HBoyd255/norm-motor-control-board/README.md

# N.O.R.M. Motor Control Board <br> (Neat Omnidirectional Robotic Module)

<!-- Harry Boyd - 30/10/2024 - github.com/hboyd255 -->

This is a board that controls the motors on Project N.O.R.M. It uses an arduino
nano 33 BLE as the controller.
