HBoyd255/norm-motor-control-board/hardware/NORMMotorControlBoard.kicad_pcb

## KiCad design hardware/NORMMotorControlBoard.kicad_pcb (2025-02-17)

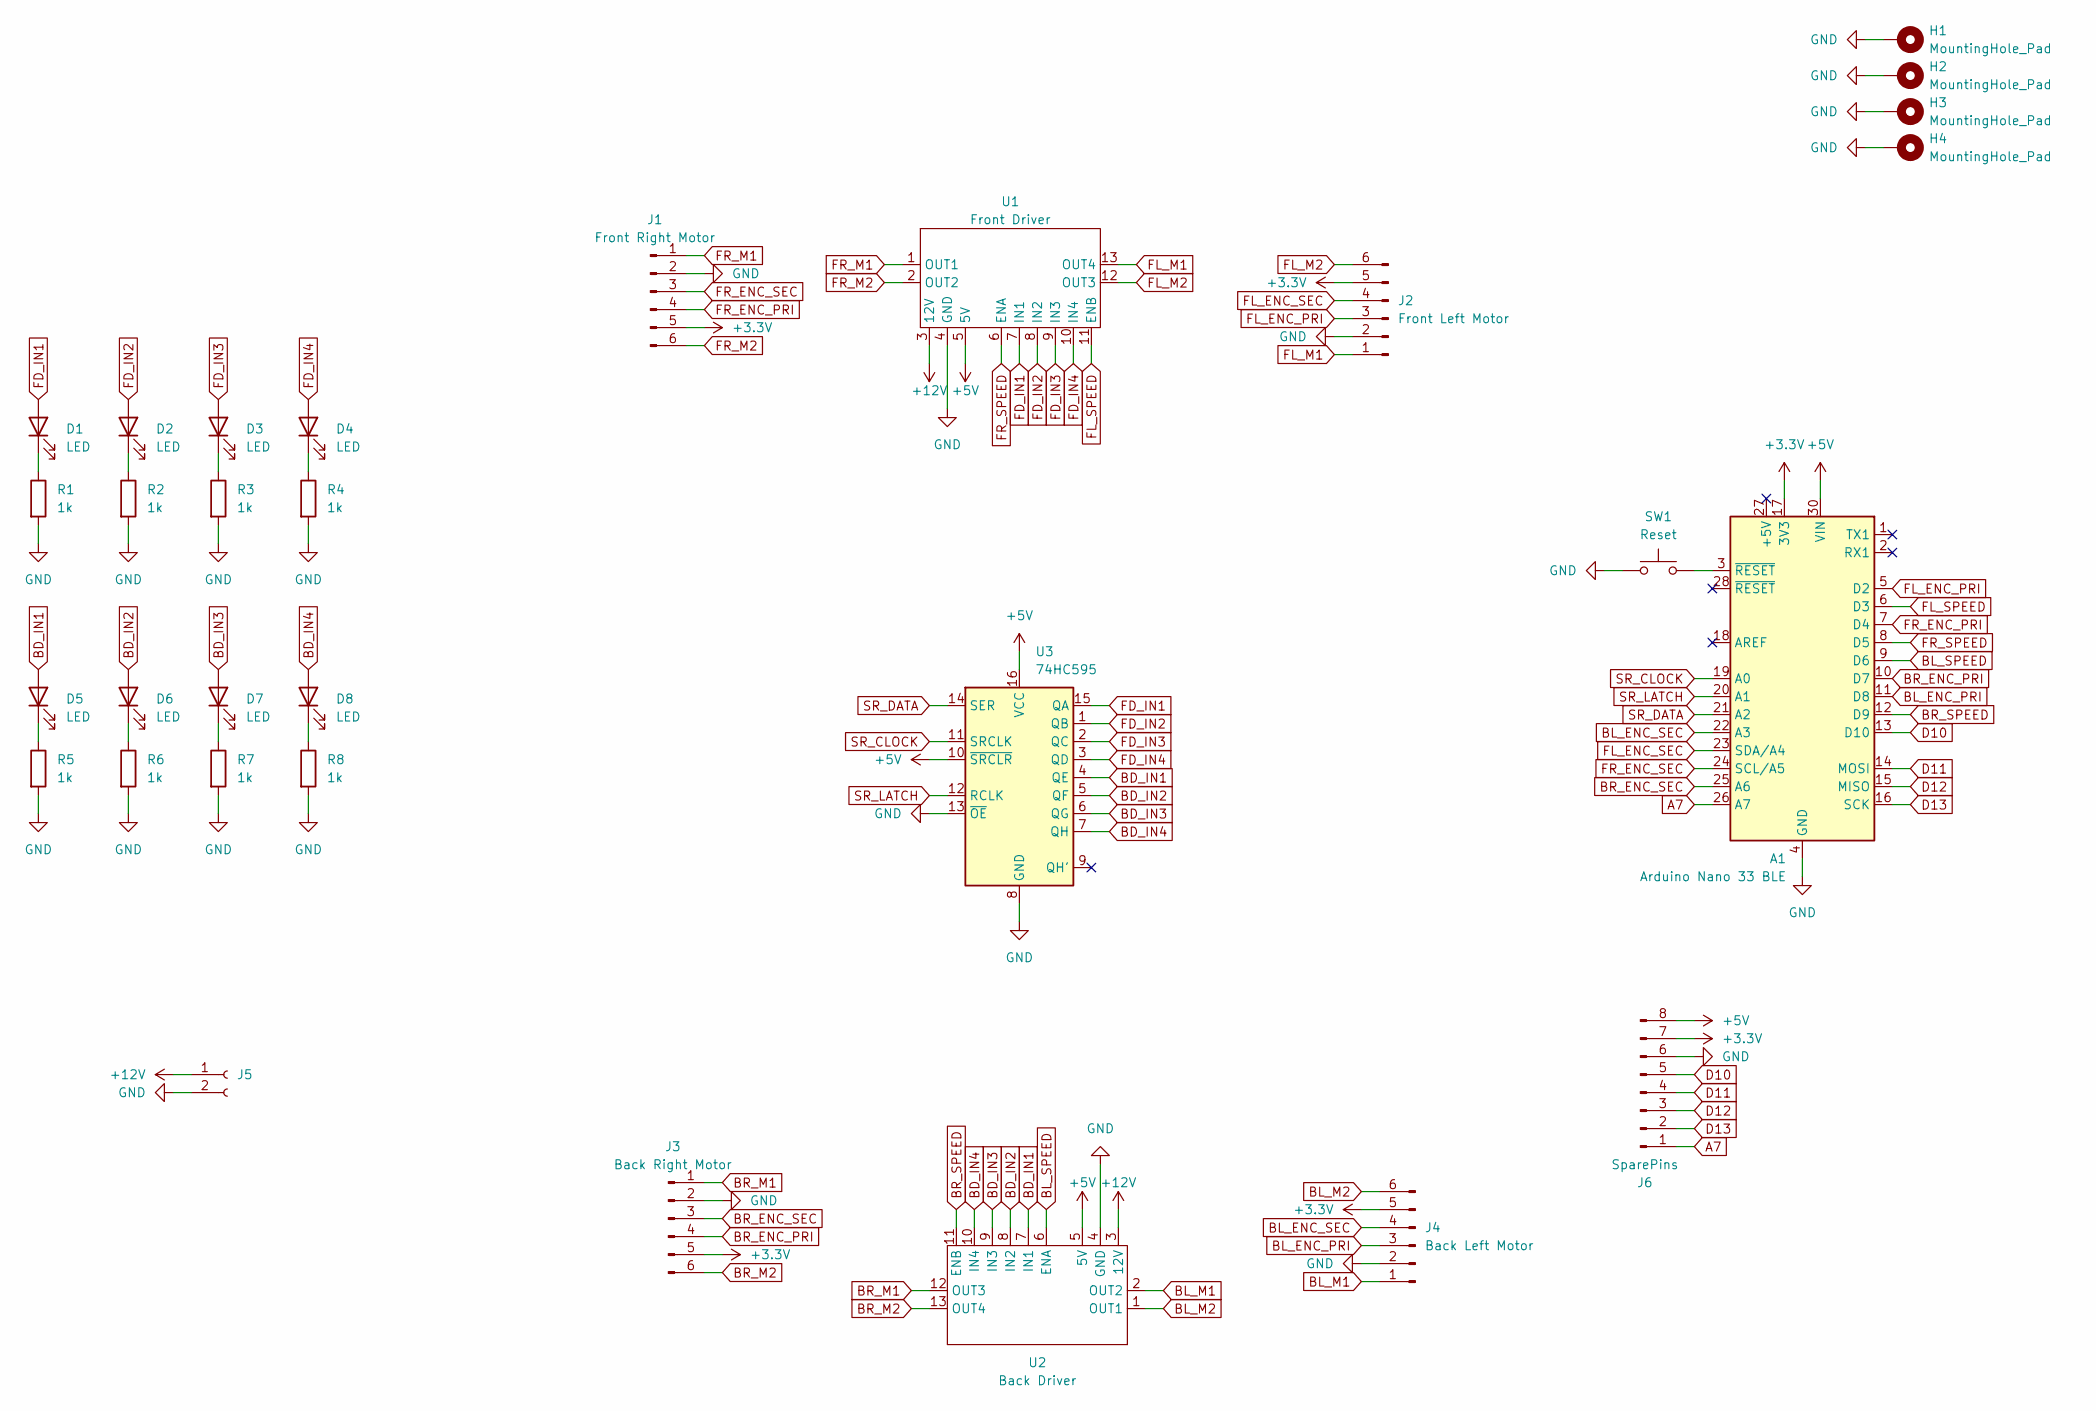
[picture p1: schematic NORMMotorControlBoard.kicad_sch]

Parts:
A1: Arduino Nano 33 BLE; Arduino_Nano
D1, D2, D3, D4, D5, D6, D7, D8: LED; LED_0603_1608Metric
H1, H2, H3, H4: MountingHole_Pad; MountingHole_2.7mm_M2.5_Pad
J1: Front Right Motor; JST_PH_S6B-PH-K_1x06_P2.00mm_Horizontal
J2: Front Left Motor; JST_PH_S6B-PH-K_1x06_P2.00mm_Horizontal
J3: Back Right Motor; JST_PH_S6B-PH-K_1x06_P2.00mm_Horizontal
J4: Back Left Motor; JST_PH_S6B-PH-K_1x06_P2.00mm_Horizontal
J5: Conn_01x02_Socket; Samtec_HPM-02-01-x-S_Straight_1x02_Pitch5.08mm
J6: SparePins; PinHeader_1x08_P2.54mm_Horizontal
R1, R2, R3, R4, R5, R6, R7, R8: 1k; R_0603_1608Metric
SW1: Reset; Two_Pin_Through_Hole_Push_Button
U1: Front Driver; L298N
U2: Back Driver; L298N
U3: 74HC595; DIP-16_W7.62mm

Connections:
+3.3V: A1.17 (3V3), J1.5, J2.5, J3.5, J4.5, J6.7
+5V: A1.30 (VIN), J6.8, U1.5 (5V), U2.5 (5V), U3.10 (~SRCLR), U3.16 (VCC)
+12V: J5.1, U1.3 (12V), U2.3 (12V)
A7: A1.26 (A7), J6.1
BD_IN1: D5.2 (A), U2.7 (IN1), U3.4 (QE)
BD_IN2: D6.2 (A), U2.8 (IN2), U3.5 (QF)
BD_IN3: D7.2 (A), U2.9 (IN3), U3.6 (QG)
BD_IN4: D8.2 (A), U2.10 (IN4), U3.7 (QH)
BL_ENC_PRI: A1.11 (D8), J4.3
BL_ENC_SEC: A1.22 (A3), J4.4
BL_M1: J4.1, U2.2 (OUT2)
BL_M2: J4.6, U2.1 (OUT1)
BL_SPEED: A1.9 (D6), U2.6 (ENA)
BR_ENC_PRI: A1.10 (D7), J3.4
BR_ENC_SEC: A1.25 (A6), J3.3
BR_M1: J3.1, U2.12 (OUT3)
BR_M2: J3.6, U2.13 (OUT4)
BR_SPEED: A1.12 (D9), U2.11 (ENB)
D10: A1.13 (D10), J6.5
D11: A1.14 (MOSI), J6.4
D12: A1.15 (MISO), J6.3
D13: A1.16 (SCK), J6.2
FD_IN1: D1.2 (A), U1.7 (IN1), U3.15 (QA)
FD_IN2: D2.2 (A), U1.8 (IN2), U3.1 (QB)
FD_IN3: D3.2 (A), U1.9 (IN3), U3.2 (QC)
FD_IN4: D4.2 (A), U1.10 (IN4), U3.3 (QD)
FL_ENC_PRI: A1.5 (D2), J2.3
FL_ENC_SEC: A1.23 (SDA/A4), J2.4
FL_M1: J2.1, U1.13 (OUT4)
FL_M2: J2.6, U1.12 (OUT3)
FL_SPEED: A1.6 (D3), U1.11 (ENB)
FR_ENC_PRI: A1.7 (D4), J1.4
FR_ENC_SEC: A1.24 (SCL/A5), J1.3
FR_M1: J1.1, U1.1 (OUT1)
FR_M2: J1.6, U1.2 (OUT2)
FR_SPEED: A1.8 (D5), U1.6 (ENA)
GND: A1.4 (GND), A1.29 (GND), H1.1, H2.1, H3.1, H4.1, J1.2, J2.2, J3.2, J4.2, J5.2, J6.6, R1.2, R2.2, R3.2, R4.2, R5.2, R6.2, R7.2, R8.2, SW1.1, U1.4 (GND), U2.4 (GND), U3.8 (GND), U3.13 (~OE)
unnamed: A1.3 (~RESET), SW1.2
unnamed: D1.1 (K), R1.1
unnamed: D2.1 (K), R2.1
unnamed: D3.1 (K), R3.1
unnamed: D4.1 (K), R4.1
unnamed: D5.1 (K), R5.1
unnamed: D6.1 (K), R6.1
unnamed: D7.1 (K), R7.1
unnamed: D8.1 (K), R8.1
SR_CLOCK: A1.19 (A0), U3.11 (SRCLK)
SR_DATA: A1.21 (A2), U3.14 (SER)
SR_LATCH: A1.20 (A1), U3.12 (RCLK)

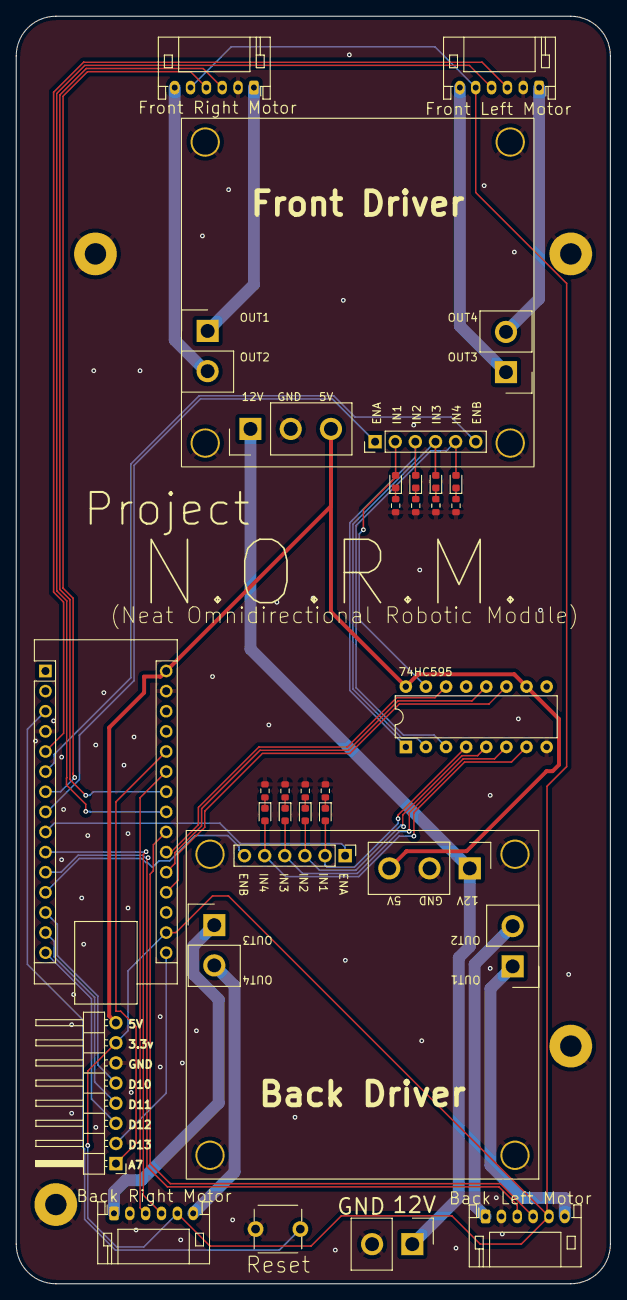
[picture p2: board NORMMotorControlBoard.kicad_pcb from above]

Board: 2 copper layers, 75.0 x 160.0 mm, 31 parts (0 on the bottom side), 49 nets.
