HBoyd255/norm-motor-control-board/(commit log)

2024-10-30 Connected nets to arduino
    [NORMMotorControlBoard.kicad_pcb, NORMMotorControlBoard.kicad_sch]
2024-10-30 Finished schematic and placed components
    [NORMMotorControlBoard.kicad_pcb, NORMMotorControlBoard.kicad_sch]
2024-10-30 Finished V1.0
    [NORMMotorControlBoard-B_Cu.gbr, NORMMotorControlBoard-B_Mask.gbr, NORMMotorControlBoard-B_Paste.gbr, NORMMotorControlBoard-B_Silkscreen.gbr, NORMMotorControlBoard-Edge_Cuts.gbr, NORMMotorControlBoard-F_Cu.gbr, NORMMotorControlBoard-F_Mask.gbr, NORMMotorControlBoard-F_Paste.gbr]
2024-11-20 Added USB C and replaced components
    [NORMMotorControlBoard.kicad_pcb, NORMMotorControlBoard.kicad_sch]
2024-11-20 renamed motor board
    [NORMMotorControlBoard.kicad_sch]
2024-11-20 Exported board v1.1
    [NORMMotorControlBoard-B_Cu.gbr, NORMMotorControlBoard-B_Mask.gbr, NORMMotorControlBoard-B_Paste.gbr, NORMMotorControlBoard-B_Silkscreen.gbr, NORMMotorControlBoard-Edge_Cuts.gbr, NORMMotorControlBoard-F_Cu.gbr, NORMMotorControlBoard-F_Mask.gbr, NORMMotorControlBoard-F_Paste.gbr]
2025-02-15 Finished schematic for V1.3
    [NORMMotorControlBoard.kicad_sch]
2025-02-17 Layout parts for L298N footprint
2025-02-17 Wired up pins of L298N footprint
2025-02-17 Finished schematic for V1.2
    [NORMMotorControlBoard.kicad_sch]
2025-02-17 Placed components
    [NORMMotorControlBoard.kicad_pcb, NORMMotorControlBoard.kicad_sch]
